DavidNQuelhas/MultipleSensorInterface/README.md

# MultipleSensorInterface
Multiple Sensor Interface - versatile RTU device
