DavidNQuelhas/MultipleSensorInterface/GUI/images/flowchart_multiple_sensor.png

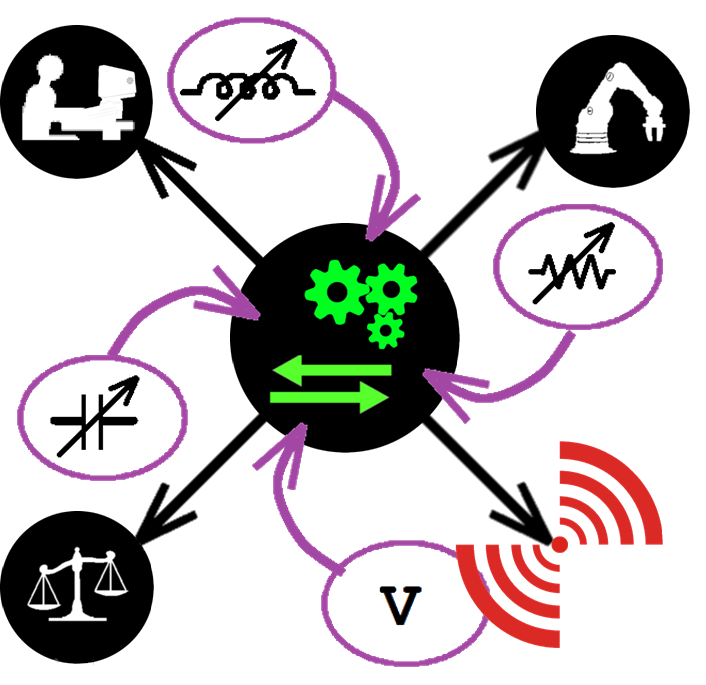
GUI/images/flowchart_multiple_sensor.png
