DavidNQuelhas/MultipleSensorInterface/KiCad/single_osc_PCB/MultipleSensor_single_osc_PCB.kicad_pcb

## KiCad design KiCad/single_osc_PCB/MultipleSensor_single_osc_PCB.kicad_pcb (2021-09-19)

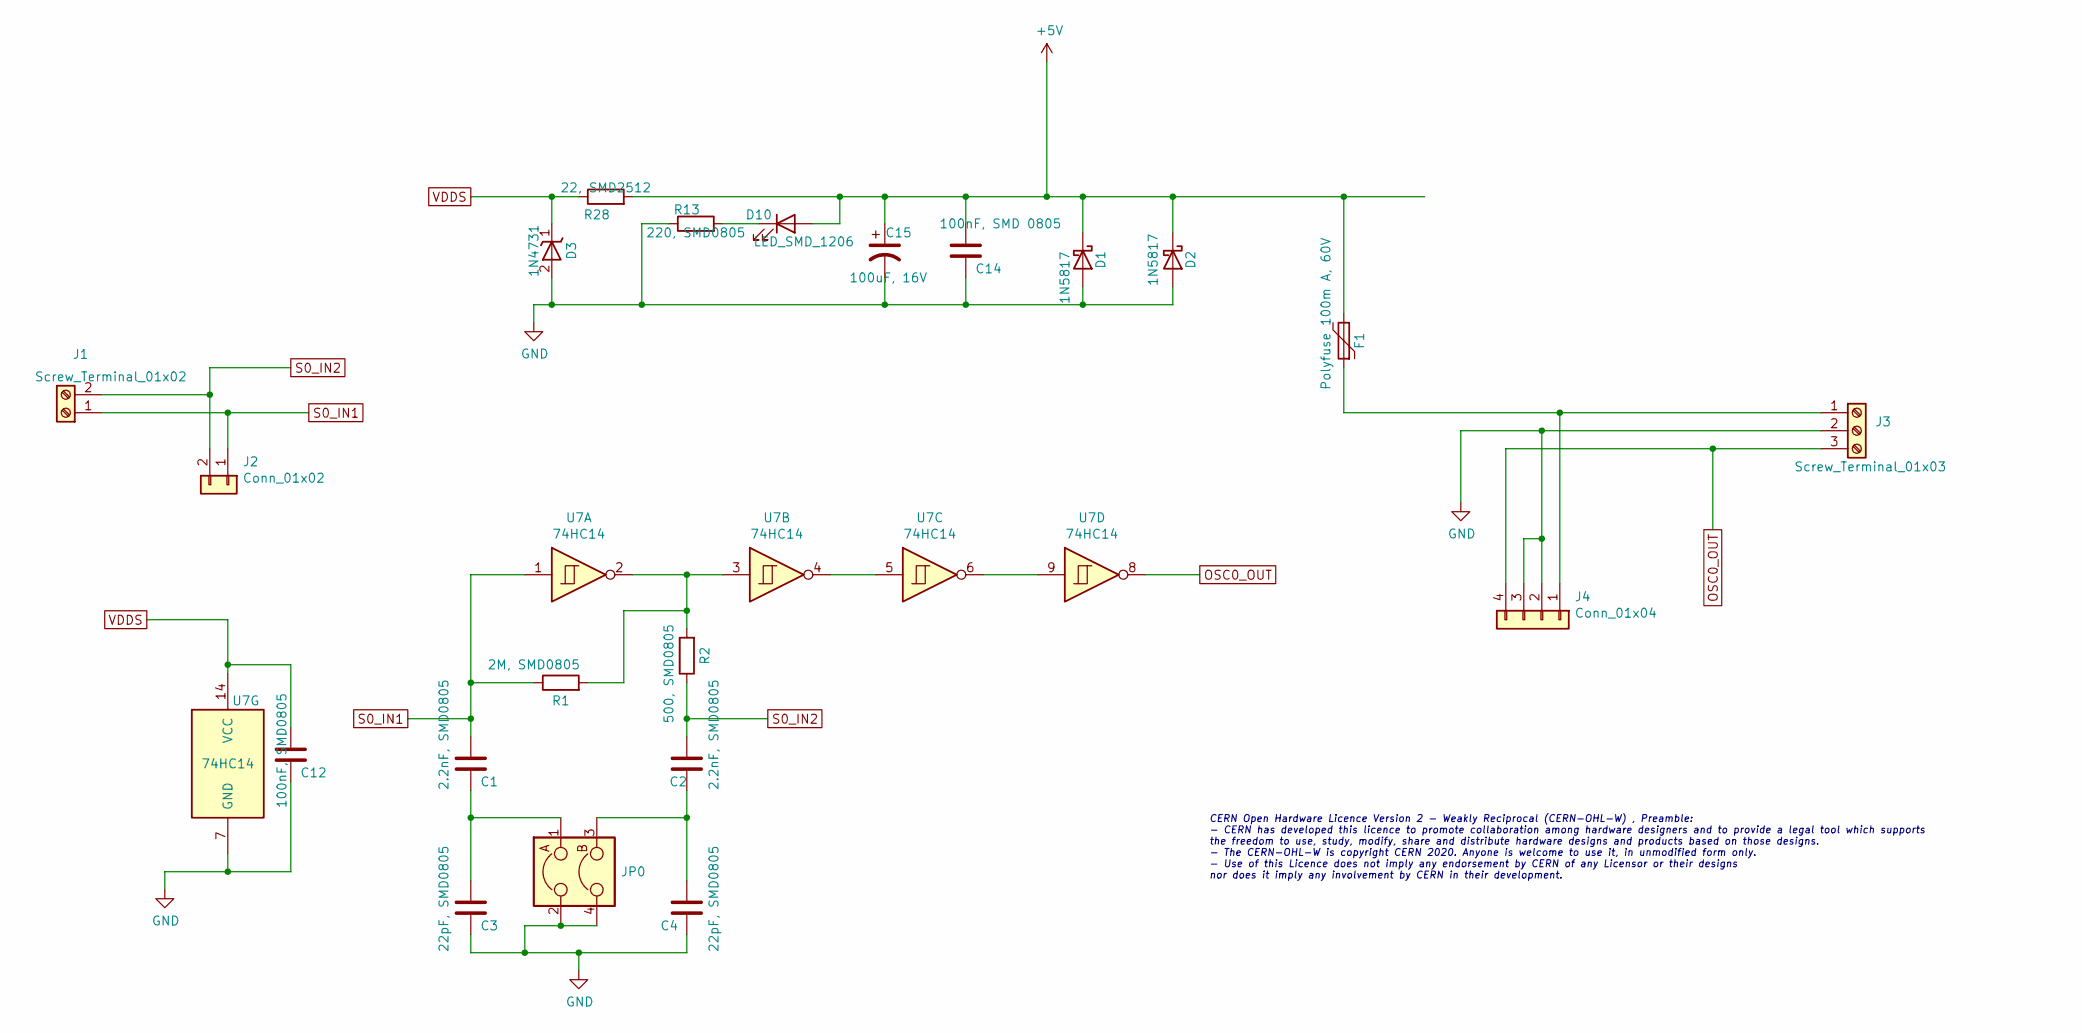
[picture p2: schematic MultipleSensor_single_osc_PCB.sch, Multiple Sensor Interface - single sensor/oscillator PCB]

Parts:
C1, C2: 2.2nF, SMD0805; C_0805_HandSoldering
C3, C4: 22pF, SMD0805; C_0805_HandSoldering
C12: 100nF, SMD0805; C_0805_HandSoldering
C14: 100nF, SMD 0805; C_0805_HandSoldering
C15: 100uF, 16V; CP_Radial_D5.0mm_P2.50mm
D1, D2: 1N5817; D_DO-41_SOD81_P10.16mm_Horizontal
D3: 1N4731; D_DO-41_SOD81_P10.16mm_Horizontal
D10: LED_SMD_1206; LED_1206
F1: Polyfuse 100m A, 60V; Fuse_TE5_Littlefuse-395Series
J1: Screw_Terminal_01x02; TerminalBlock_Screw_1x2_3.96mm
J2: Conn_01x02; PinHeader_1x02_P2.54mm_Vertical_HandSoldering
J3: Screw_Terminal_01x03; TerminalBlock_Screw_1x3_3.96mm
J4: Conn_01x04; PinHeader_1x04_P2.54mm_Vertical_HandSoldering
JP0: 2_jumpers_related; 2_jumpers_related_2.54mm
R1: 2M, SMD0805; R_0805_HandSoldering
R2: 500, SMD0805; R_0805_HandSoldering
R13: 220, SMD0805; R_0805_HandSoldering
R28: 22, SMD2512; R_2512_HandSoldering
U7: 74HC14; SOIC-14_3.9x8.7mm_Pitch1.27mm_HandSoldering

Connections:
+5V: C14.1, C15.1, D1.1 (K), D2.1 (K), D10.2 (A), F1.2, R28.2
GND: C3.2, C4.2, C12.2, C14.2, C15.2, D1.2 (A), D2.2 (A), D3.2 (A), J3.2, J4.2, J4.3, JP0.2, JP0.4, R13.1, U7.7 (GND)
unnamed: C1.2, C3.1, JP0.1
unnamed: C2.2, C4.1, JP0.3
unnamed: D10.1 (K), R13.2
unnamed: F1.1, J3.1, J4.1
unnamed: R1.2, R2.2, U7.2, U7.3
unnamed: U7.4, U7.5
unnamed: U7.6, U7.9
OSC0_OUT: J3.3, J4.4, U7.8
S0_IN1: C1.1, J1.1, J2.1, R1.1, U7.1
S0_IN2: C2.1, J1.2, J2.2, R2.1
VDDS: C12.1, D3.1 (K), R28.1, U7.14 (VCC)

Notes on the sheet:
CERN Open Hardware Licence Version 2 - Weakly Reciprocal (CERN-OHL-W) , Preamble: - CERN has developed this licence to promote collaboration among hardware designers and to provide a legal tool which supports the freedom to use, study, modify, share and distribute hardware designs and products base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

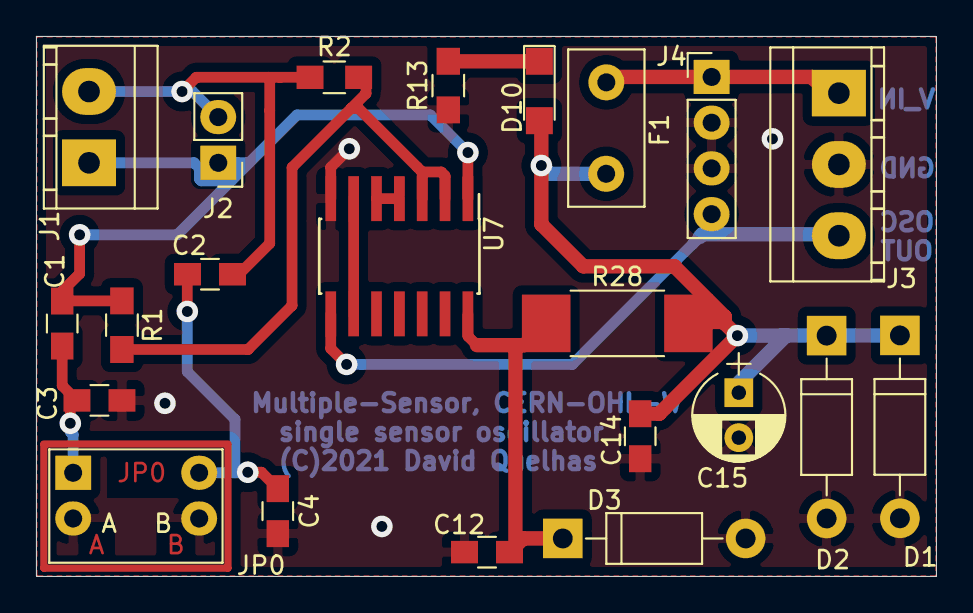
[picture p3: board MultipleSensor_single_osc_PCB.kicad_pcb from above]

Board: 2 copper layers, 50.0 x 30.0 mm, 22 parts (0 on the bottom side), 13 nets.
