DavidNQuelhas/MultipleSensorInterface/KiCad/PCB/MultipleSensor_PCB.kicad_pcb

## KiCad design KiCad/PCB/MultipleSensor_PCB.kicad_pcb (2021-09-19)

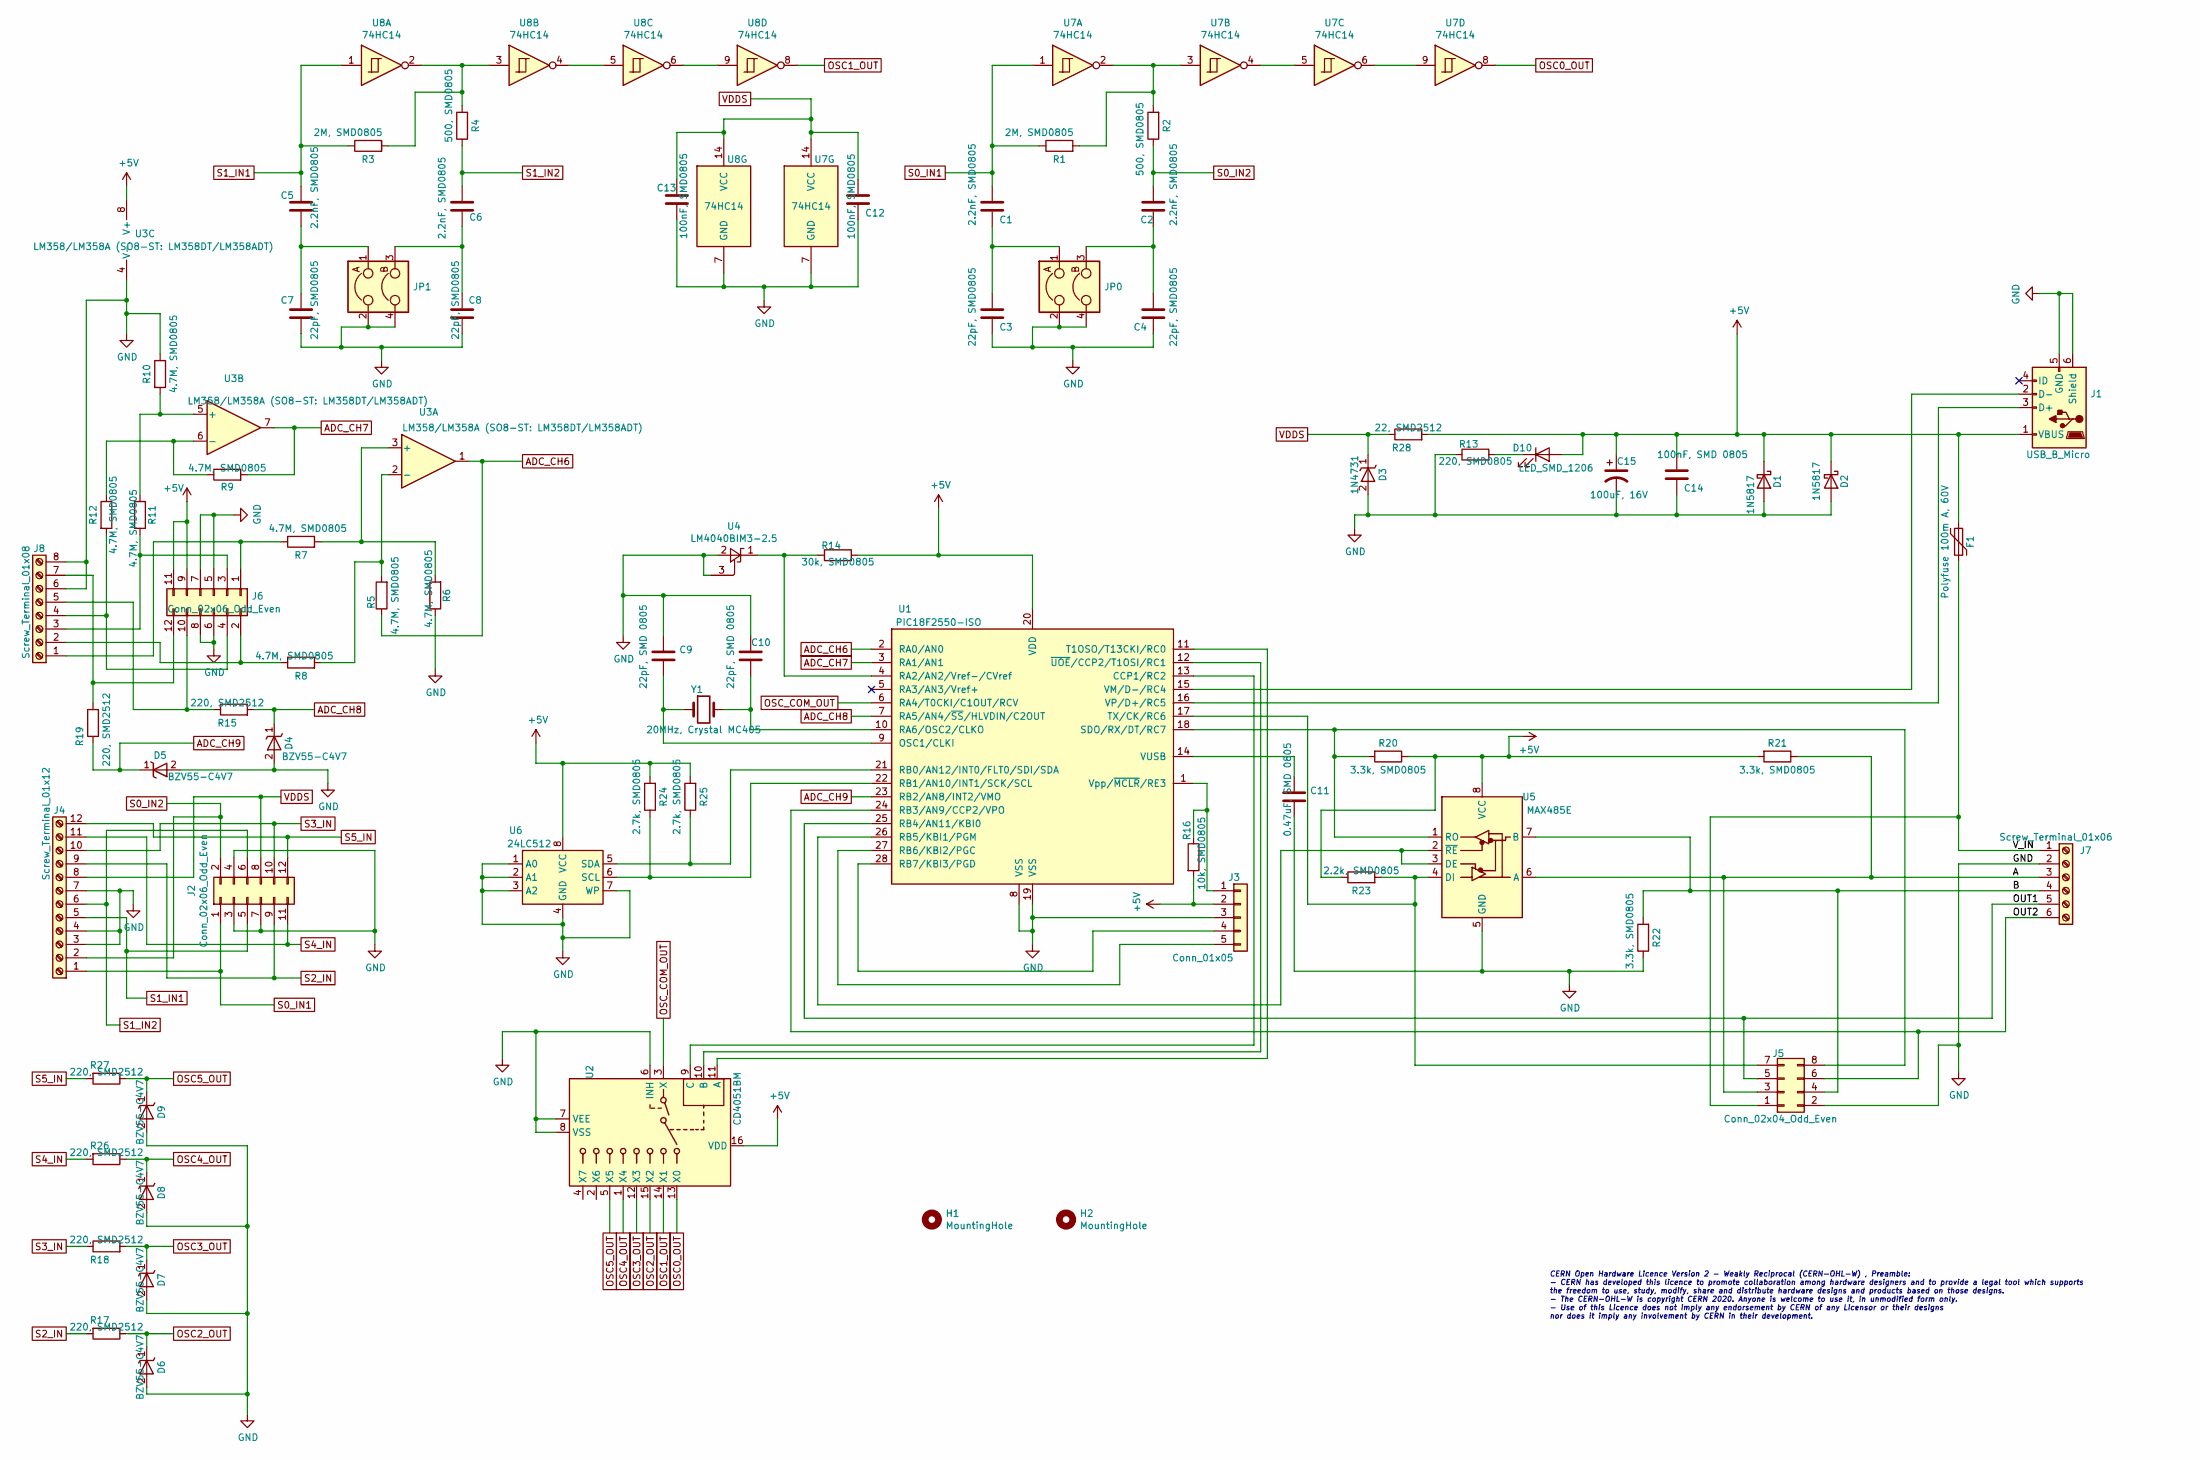
[picture p4: schematic MultipleSensor_PCB.sch, Multiple Sensor Interface]

Parts:
C1, C2, C5, C6: 2.2nF, SMD0805; C_0805_HandSoldering
C3, C4, C7, C8: 22pF, SMD0805; C_0805_HandSoldering
C9, C10: 22pF, SMD 0805; C_0805_HandSoldering
C11: 0.47uF, SMD 0805; C_0805_HandSoldering
C12, C13: 100nF, SMD0805; C_0805_HandSoldering
C14: 100nF, SMD 0805; C_0805_HandSoldering
C15: 100uF, 16V; CP_Radial_D5.0mm_P2.50mm
D1, D2: 1N5817; D_DO-41_SOD81_P10.16mm_Horizontal
D3: 1N4731; D_DO-41_SOD81_P10.16mm_Horizontal
D4, D5, D6, D7, D8, D9: BZV55-C4V7; D_1206
D10: LED_SMD_1206; LED_1206
F1: Polyfuse 100m A, 60V; Fuse_TE5_Littlefuse-395Series
H1, H2: MountingHole; MountingHole_3.2mm_M3_Pad
J1: USB_B_Micro; USB_mini_B_HandSoldering
J2, J6: Conn_02x06_Odd_Even; PinHeader_2x06_P2.54mm_Vertical_HandSoldering
J3: Conn_01x05; PinHeader_1x05_P2.54mm_Vertical_HandSoldering
J4: Screw_Terminal_01x12; TerminalBlock_Screw_1x12_3.96mm
J5: Conn_02x04_Odd_Even; PinHeader_2x04_P2.54mm_Vertical_HandSoldering
J7: Screw_Terminal_01x06; TerminalBlock_Screw_1x6_3.96mm
J8: Screw_Terminal_01x08; TerminalBlock_Screw_1x8_3.96mm_mirror
JP0, JP1: 2_jumpers_related; 2_jumpers_related_2.54mm
R1, R3: 2M, SMD0805; R_0805_HandSoldering
R2, R4: 500, SMD0805; R_0805_HandSoldering
R5, R6, R7, R8, R9, R10, R11, R12: 4.7M, SMD0805; R_0805_HandSoldering
R13: 220, SMD0805; R_0805_HandSoldering
R14: 30k, SMD0805; R_0805_HandSoldering
R15, R17, R18, R19, R26, R27: 220, SMD2512; R_2512_HandSoldering
R16: 10k, SMD0805; R_0805_HandSoldering
R20, R21, R22: 3.3k, SMD0805; R_0805_HandSoldering
R23: 2.2k, SMD0805; R_0805_HandSoldering
R24, R25: 2.7k, SMD0805; R_0805_HandSoldering
R28: 22, SMD2512; R_2512_HandSoldering
U1: PIC18F2550-ISO; SOIC-28W_7.5x17.9mm_P1.27mm_HandSoldering
U2: CD4051BM; SOIC-16_3.9x9.9mm_Pitch1.27mm_HandSoldering
U3: LM358/LM358A (SO8-ST: LM358DT/LM358ADT); SOIC-8_3.9x4.9mm_Pitch1.27mm_HandSoldering
U4: LM4040BIM3-2.5; SOT-23_HandSoldering2
U5: MAX485E; SOIC-8_3.9x4.9mm_Pitch1.27mm_HandSoldering
U6: 24LC512; SOIC-8_3.9x4.9mm_Pitch1.27mm_HandSoldering
U7, U8: 74HC14; SOIC-14_3.9x8.7mm_Pitch1.27mm_HandSoldering
Y1: 20MHz, Crystal MC405; Crystal_SMD_MC405-2pin_9.6mmx4.1mm_HandSoldering

Connections:
+5V: C14.1, C15.1, D1.1 (K), D2.1 (K), D10.2 (A), F1.2, J1.1 (VBUS), J3.2, J6.9, J6.11, R14.2, R16.2, R20.1, R21.2, R23.1, R24.2, R25.2, R28.2, U1.20 (VDD), U2.16 (VDD), U3.8 (V+), U5.8 (VCC), U6.8 (VCC)
/A: J5.3, J7.3, R21.1, U5.6 (A)
/B: J5.4, J7.4, R22.2, U5.7 (B)
/OUT1: J5.5, J7.5, U1.25 (RB4/AN11/KBI0)
/OUT2: J5.6, J7.6, U1.24 (RB3/AN9/CCP2/VPO)
/V_IN: F1.1, J5.1, J7.1
ADC_CH6: R5.1, U1.2 (RA0/AN0), U3.1
ADC_CH7: R9.2, U1.3 (RA1/AN1), U3.7
ADC_CH8: D4.1 (K), R15.2, U1.7 (RA5/AN4/~SS~/HLVDIN/C2OUT)
ADC_CH9: D5.1 (K), R19.1, U1.23 (RB2/AN8/INT2/VMO)
GND: C3.2, C4.2, C7.1, C8.1, C9.1, C10.1, C11.2, C12.2, C13.1, C14.2, C15.2, D1.2 (A), D2.2 (A), D3.2 (A), D4.2 (A), D5.2 (A), D6.2 (A), D7.2 (A), D8.2 (A), D9.2 (A), J1.5 (GND), J1.6 (Shield), J2.3, J2.4, J2.7, J3.3, J4.3, J4.4, J4.7, J5.2, J6.5, J6.6, J6.7, J6.8, J7.2, J8.6, J8.8, JP0.2, JP0.4, JP1.2, JP1.4, R6.1, R10.1, R13.1, R22.1, U1.8 (VSS), U1.19 (VSS), U2.6 (INH), U2.7 (VEE), U2.8 (VSS), U3.4 (V-), U4.2 (A), U4.3 (B), U5.5 (GND), U6.1 (A0), U6.2 (A1), U6.3 (A2), U6.4 (GND), U6.7 (WP), U7.7 (GND), U8.7 (GND)
unnamed: C1.2, C3.1, JP0.1
unnamed: C2.2, C4.1, JP0.3
unnamed: C5.1, C7.2, JP1.1
unnamed: C6.2, C8.2, JP1.3
unnamed: C9.2, U1.9 (OSC1/CLKI), Y1.1
unnamed: C10.2, U1.10 (RA6/OSC2/CLKO), Y1.2
unnamed: C11.1, U1.14 (VUSB)
unnamed: D10.1 (K), R13.2
unnamed: J1.2 (D-), U1.15 (VM/D-/RC4)
unnamed: J1.3 (D+), U1.16 (VP/D+/RC5)
unnamed: J3.1, R16.1, U1.1 (Vpp/~MCLR~/RE3)
unnamed: J3.4, U1.28 (RB7/KBI3/PGD)
unnamed: J3.5, U1.27 (RB6/KBI2/PGC)
unnamed: J5.7, R23.2, U1.17 (TX/CK/RC6), U5.4 (DI)
unnamed: J5.8, R20.2, U1.18 (SDO/RX/DT/RC7), U5.1 (RO)
unnamed: J6.1, J8.1, R7.1
unnamed: J6.2, J8.2, R8.1
unnamed: J6.3, J8.3, R11.1
unnamed: J6.4, J8.4, R12.2
unnamed: J6.10, J8.5, R15.1
unnamed: J6.12, J8.7, R19.2
unnamed: R1.2, R2.2, U7.2, U7.3
unnamed: R3.2, R4.2, U8.2, U8.3
unnamed: R5.2, R8.2, U3.2 (-)
unnamed: R6.2, R7.2, U3.3 (+)
unnamed: R10.2, R11.2, U3.5 (+)
unnamed: R9.1, R12.1, U3.6 (-)
unnamed: R14.1, U1.4 (RA2/AN2/Vref-/CVref), U4.1 (K)
unnamed: R24.1, U1.22 (RB1/AN10/INT1/SCK/SCL), U6.6 (SCL)
unnamed: R25.1, U1.21 (RB0/AN12/INT0/FLT0/SDI/SDA), U6.5 (SDA)
unnamed: U1.11 (T1OSO/T13CKI/RC0), U2.11 (A)
unnamed: U1.12 (~UOE~/CCP2/T1OSI/RC1), U2.10 (B)
unnamed: U1.13 (CCP1/RC2), U2.9 (C)
unnamed: U1.26 (RB5/KBI1/PGM), U5.2 (~RE), U5.3 (DE)
unnamed: U7.4, U7.5
unnamed: U7.6, U7.9
unnamed: U8.4, U8.5
unnamed: U8.6, U8.9
OSC0_OUT: U2.13 (X0), U7.8
OSC1_OUT: U2.14 (X1), U8.8
OSC2_OUT: D6.1 (K), R17.1, U2.15 (X2)
OSC3_OUT: D7.1 (K), R18.2, U2.12 (X3)
OSC4_OUT: D8.1 (K), R26.1, U2.1 (X4)
OSC5_OUT: D9.1 (K), R27.1, U2.5 (X5)
OSC_COM_OUT: U1.6 (RA4/T0CKI/C1OUT/RCV), U2.3 (X)
S0_IN1: C1.1, J2.1, J4.1, R1.1, U7.1
S0_IN2: C2.1, J2.2, J4.2, R2.1
S1_IN1: C5.2, J2.5, J4.5, R3.1, U8.1
S1_IN2: C6.1, J2.6, J4.6, R4.1
S2_IN: J2.9, J4.9, R17.2
S3_IN: J2.10, J4.10, R18.1
S4_IN: J2.11, J4.11, R26.2
S5_IN: J2.12, J4.12, R27.2
VDDS: C12.1, C13.2, D3.1 (K), J2.8, J4.8, R28.1, U7.14 (VCC), U8.14 (VCC)

Notes on the sheet:
CERN Open Hardware Licence Version 2 - Weakly Reciprocal (CERN-OHL-W) , Preamble: - CERN has developed this licence to promote collaboration among hardware designers and to provide a legal tool which supports the freedom to use, study, modify, share and distribute hardware designs and products base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

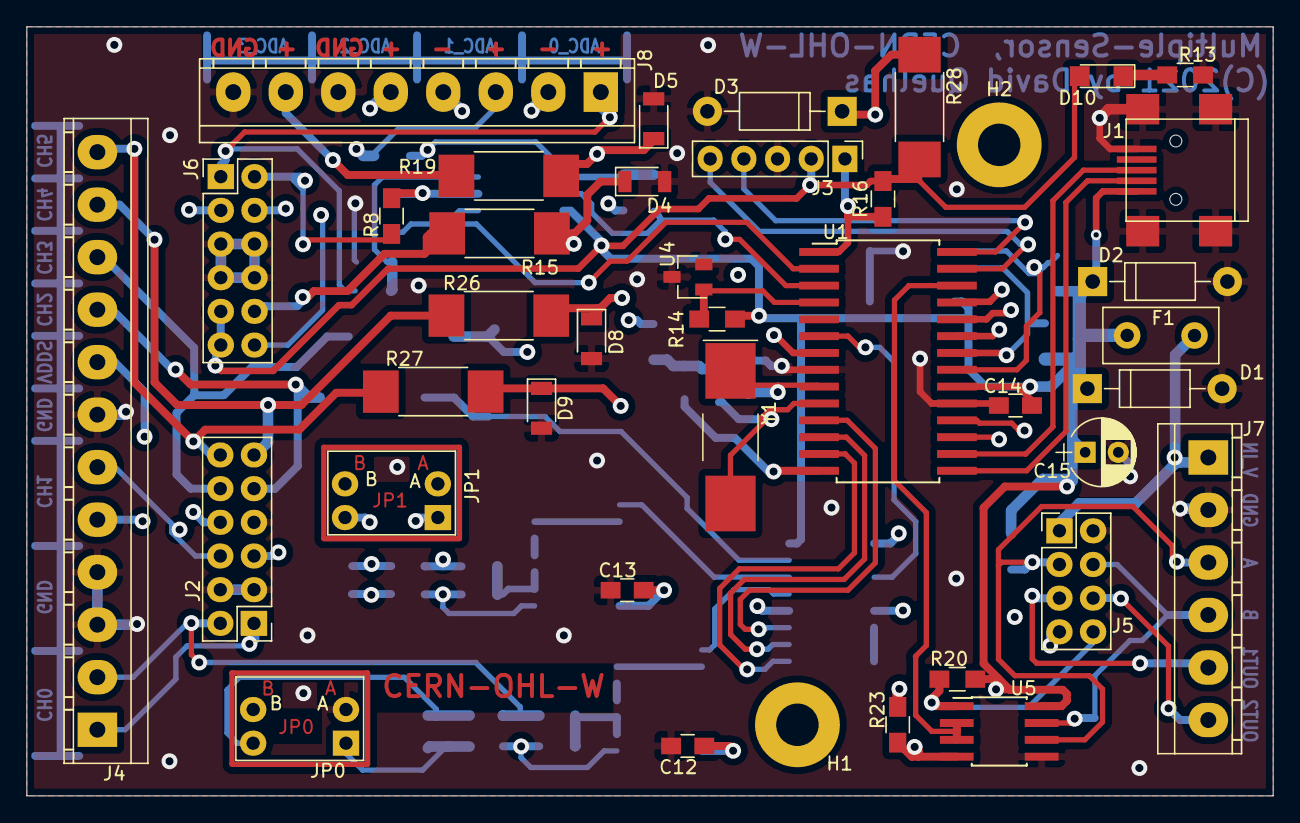
[picture p5: board MultipleSensor_PCB.kicad_pcb from above]

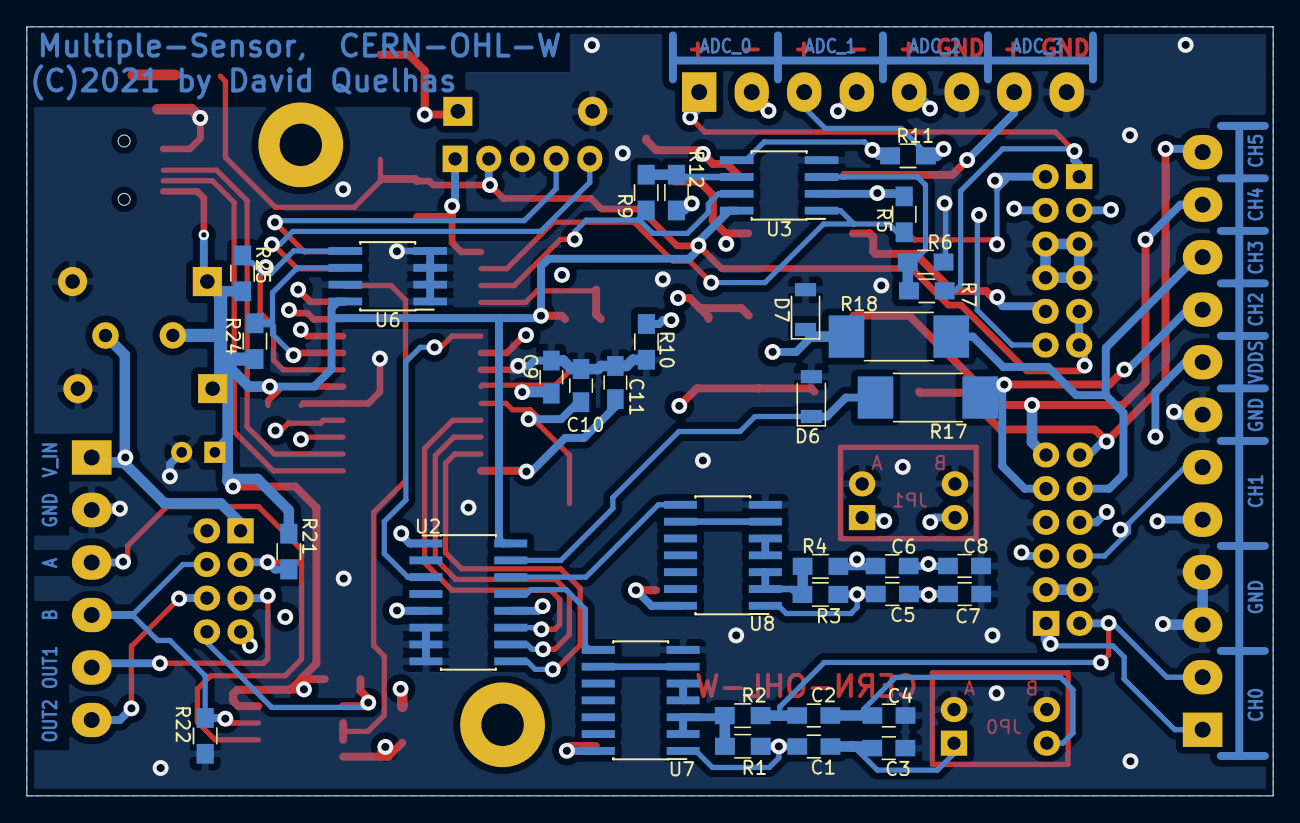
[picture p6: board MultipleSensor_PCB.kicad_pcb from below]

Board: 4 copper layers, 94.0 x 58.0 mm, 75 parts (35 on the bottom side), 65 nets.
