DavidNQuelhas/MultipleSensorInterface/(notices)

Notices in the files:
KiCad/PCB/MultipleSensor_PCB.sch:
David N. G. da Silva S. Quelhas (Lisboa - Portugal) , License: CERN-OHL-W
- The CERN-OHL-W is copyright CERN 2020. Anyone is welcome to use it, in unmodified form only.
KiCad/PCB/MultipleSensor_PCB.kicad_pcb:
Multiple-Sensor, CERN-OHL-W
(C)2021 by David Quelhas
KiCad/single_osc_PCB/MultipleSensor_single_osc_PCB.kicad_pcb:
(C)2021 David Quelhas
